Saturday-365/E-Shift-CZCD/THIRD_PARTY.md

# 第三方内容与许可证说明

仓库根目录的 GPL-3.0 适用于项目原创软件代码，不改变第三方组件原有的许可证和版权归属。

## STM32 HAL 与 CMSIS

各固件工程中的 `Drivers` 目录由 STM32CubeMX/STM32Cube 固件包生成或复制，包含 STMicroelectronics HAL 与 Arm CMSIS。

相关许可证文件随对应目录保留，例如：

- `Drivers/STM32F4xx_HAL_Driver/LICENSE.txt`
- `Drivers/CMSIS/LICENSE.txt`
- `Drivers/CMSIS/Device/ST/STM32F4xx/LICENSE.txt`

使用、修改和再分发这些文件时应遵守其各自许可证，而不是仅依据仓库根目录的 GPL-3.0。

## CyberGear 相关代码

`Sourse_Library/4_XMCyberGear_Libary` 包含 CyberGear 通信和控制实现。部分协议定义来源于电机公开资料及项目早期参考代码。

在来源和许可证逐文件核对完成前：

- 不应从根目录许可证推断所有第三方片段均可按 GPL 再授权。
- 新贡献需要注明参考资料、原作者和链接。
- 不应直接复制来源不明的完整驱动实现。

## ECU 与通信协议

ECU CAN 数据解析基于实际车辆接口、设备文档和调试结果。协议字段是否允许公开再分发应由使用者结合设备许可确认。

## 厂商软件、固件与手册

`4_Document` 中历史上保存过电机调试器、串口工具、设备固件和厂商手册。这些文件不一定具有公开再分发授权。

仓库整理原则：

- 优先保留项目原创说明和必要的公开标准。
- 厂商软件改为提供产品名称、版本和官方下载地址。
- 无法确认许可的 EXE、DLL、固件包和整套运行环境不继续纳入主分支。
- 引用厂商文档时保留标题、版本、来源链接和访问日期。

## 硬件、机械与文档

PCB、机械模型、图片和文档的独立许可证仍待团队确认。在车队成员和共同作者完成授权确认前，不应假定这些内容自动采用 GPL-3.0。

后续计划为原创软件、开放硬件和文档分别提供清晰的 SPDX 标识与许可证说明。
