Saturday-365/E-Shift-CZCD/docs/development-log.md

# 开发记录与设计说明

本文件保留项目中的故障、取舍和待验证方案。内容按证据成熟度区分为“已验证”“观察结果”和“方案阶段”。

## 已验证或已复现的问题

| 日期 | 记录 |
| --- | --- |
| 2025-03-30 | 基础版解决部分档位数据跳变，但出现从空档再次升档跳到二档的问题。 |
| 2025-06-20 | 调整升档断火触发时机，并增加断火等待。 |
| 2025-08-30 | 修改拨片按键处理，增加用户指示灯和空档设置按钮。 |
| 2025-09-04 | V3 PCB CAN 收发器出现接地不良，返修后继续测试。 |
| 2025-09-09 | V3 PCB 点火后出现 CAN 通信异常，临时切回 V2 PCB 保证出车。 |
| 2025-09-14 | 去除两处延时以提高换挡速度，后续测试因车辆机械故障中断。 |
| 2025-09-19 | PCB 更新至 V3.1。 |
| 2025-09-28 | 连续出车约 11 分钟后出现疑似电机过温保护。 |
| 2025-10-04 | 一档弹射测试后换挡电机支架弯曲，随后加急制作 10 mm 厚支架。 |
| 2025 比赛日 | 使用新支架完成比赛，湿地直线加速记录为 4.73 s 和 4.75 s。 |
| 2026-06-05 | 总结电控离合压降、换挡速度和降档转速匹配风险。 |

## 当前设计取舍

### 断火与补油

代码保留升档断火和降档补油接口，但比赛时未启用。主要原因包括：

- ECU 新固件无法按旧方式控制带档滑行时的电子节气门。
- 春风 CLX700 档位信号在切换中会短暂经过空档，影响按档位配置的断火时间。
- 赛季车辆测试时间不足，无法完成 ECU 与集成板的联合标定。

因此比赛阶段将油门配合交给车手。该取舍不能证明自动断火或补油逻辑已经完成验证。

### 电控离合

- 保持离合分离时观察到电池压降约 2 V，因此未用于起步。
- 不使用离合可以缩短换挡动作链路。
- 离合有助于提高换挡成功率，但恢复联动时机不当可能导致后轮转速突变。
- 若重新启用，应增加转速条件、动作超时和失效回退。

### 档位处理

当前档位稳定逻辑用于过滤换挡过程中短暂出现的空档。真实空档仍需要通过按键重新设置内部状态，这是待解决限制。

## 方案阶段：通过电机力矩识别入档

对于无法搭建独立档位传感器闭环的车辆，可研究使用 CyberGear 回传力矩或电流识别是否入档：

1. 记录换挡全过程中的位置、速度、力矩和电流。
2. 对齐已知成功、失败和卡滞换挡样本。
3. 分离机械限位、齿轮入档和异常阻力产生的力矩突变。
4. 使用阈值与持续时间构造初步检测器。
5. 在不同油温、转速、供电电压和机械磨损条件下验证。
6. 检测结果只能作为状态估计，必须保留超时和人工回退。

该方案目前没有进入主固件，也没有足够数据证明可靠性。

## 路线图

- 将阻塞式换挡流程改为周期推进的非阻塞状态机。
- 将车辆相关参数集中到独立配置文件。
- 为档位稳定、CAN 解析和状态机增加主机端测试。
- 增加 CAN 超时、电机过温和传感器异常保护。
- 按测试记录规范补充字段、单位、采样率和对应提交。
- 补充通用硬件生产文件及机械交换格式。
