Saturday-365/E-Shift-CZCD/images/README/1760525655132.png

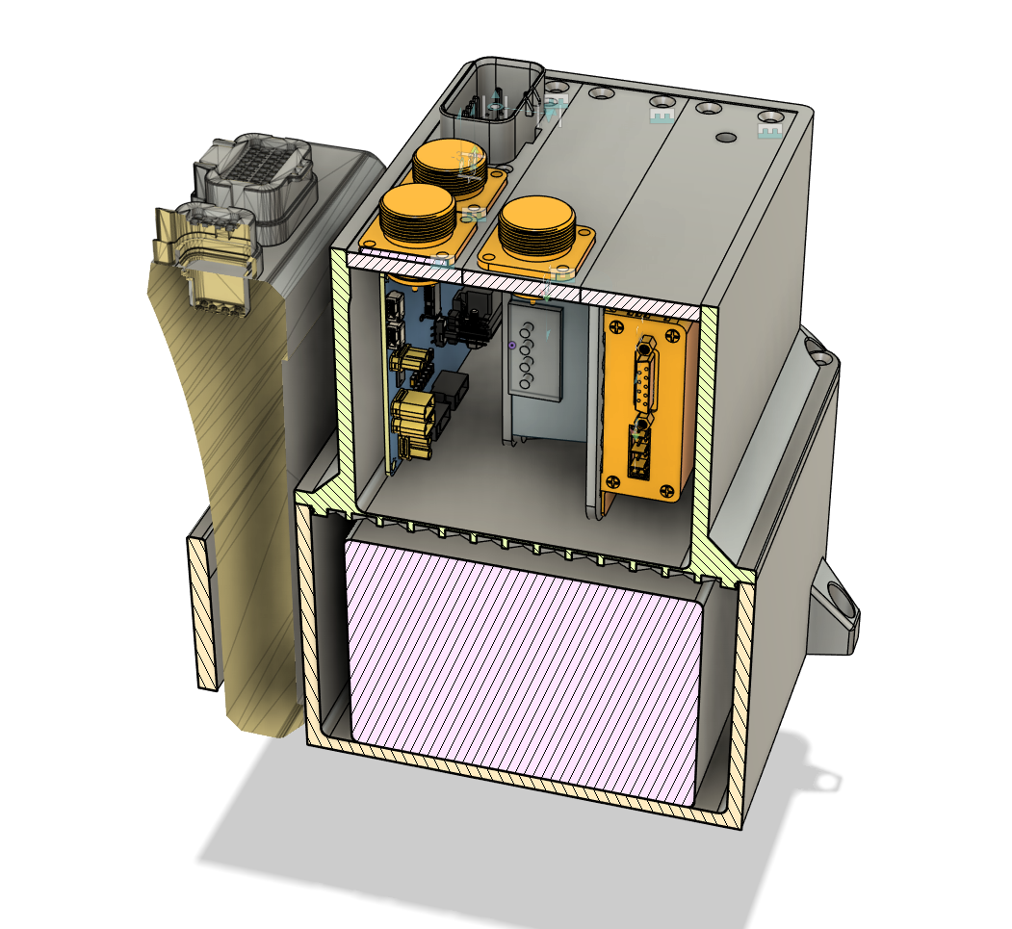
images/README/1760525655132.png
