Saturday-365/E-Shift-CZCD/images/README/1760610131903.png

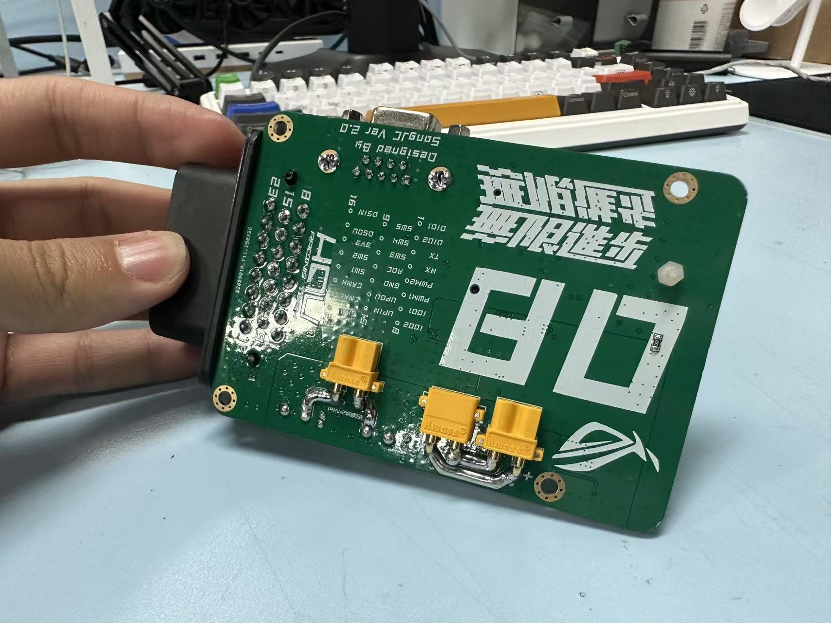
images/README/1760610131903.png
