Saturday-365/E-Shift-CZCD/images/README/1760610145923.png

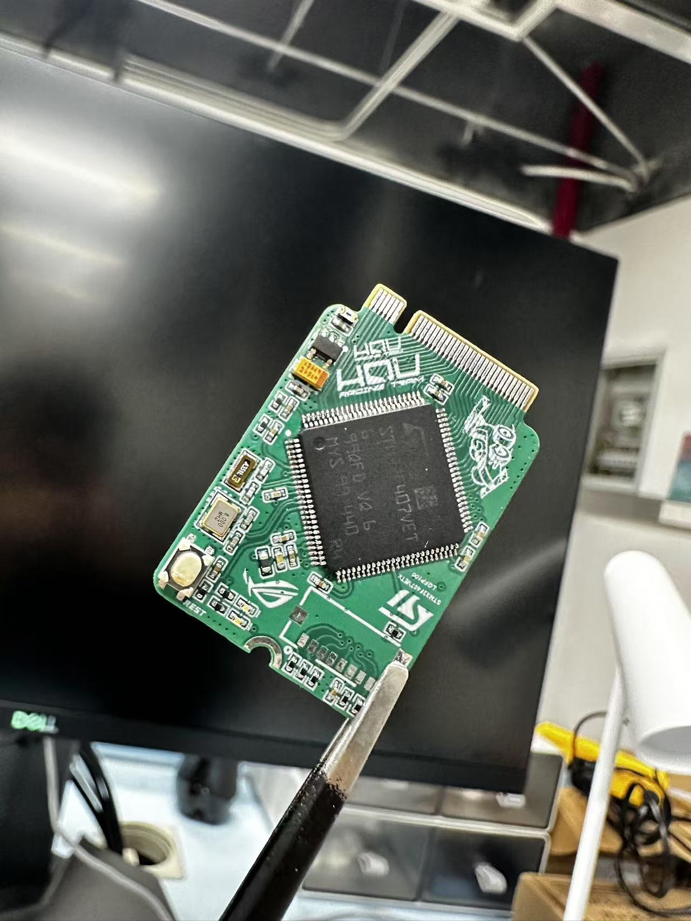
images/README/1760610145923.png
