Saturday-365/E-Shift-CZCD/images/README/1760610180186.png

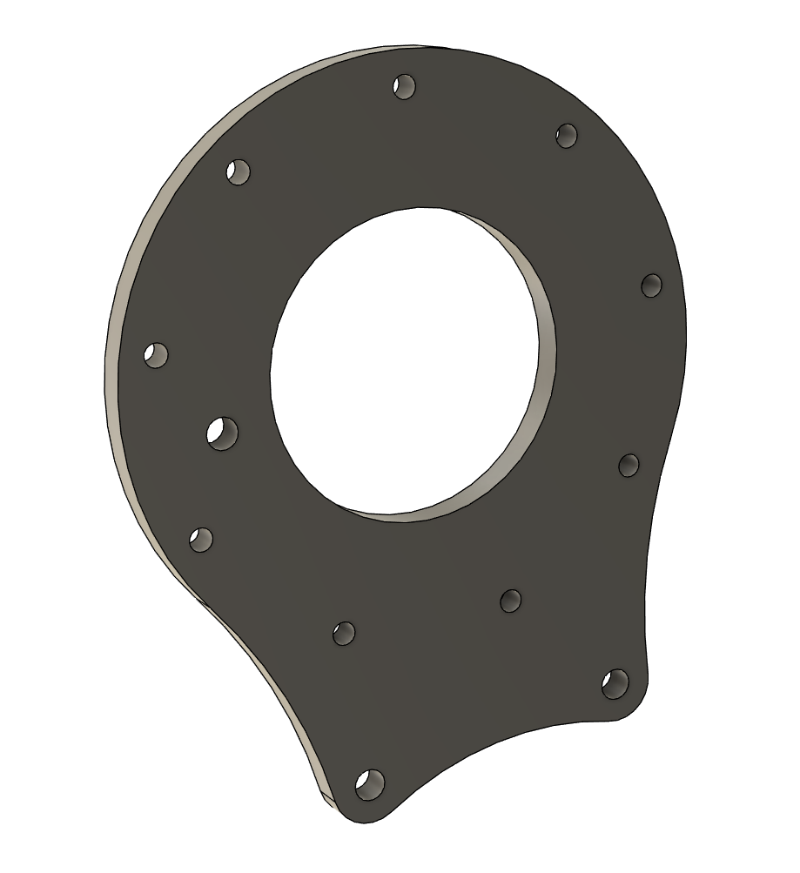
images/README/1760610180186.png
