Saturday-365/E-Shift-CZCD/images/README/1760610187072.png

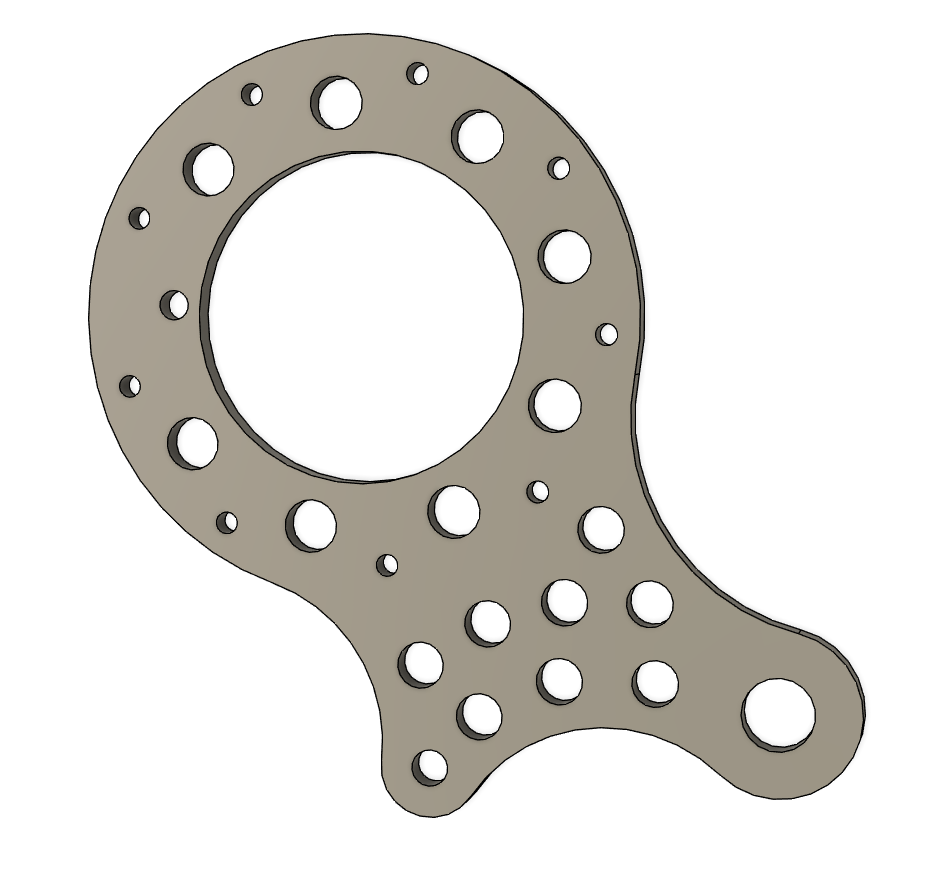
images/README/1760610187072.png
