Saturday-365/E-Shift-CZCD/images/README/1760610199821.png

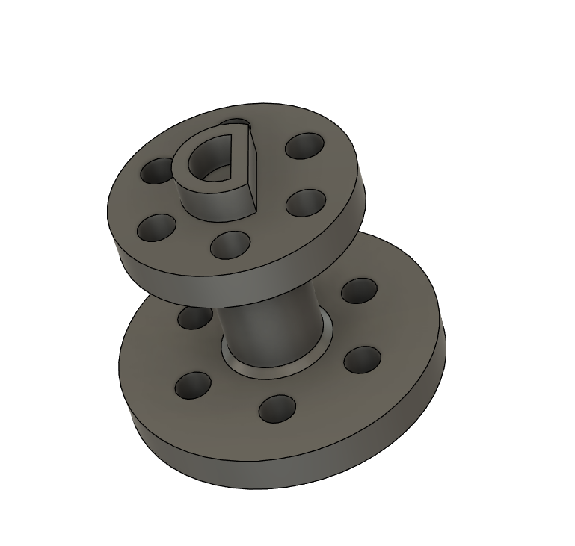
images/README/1760610199821.png
