Saturday-365/E-Shift-CZCD/images/README/1760611762846.png

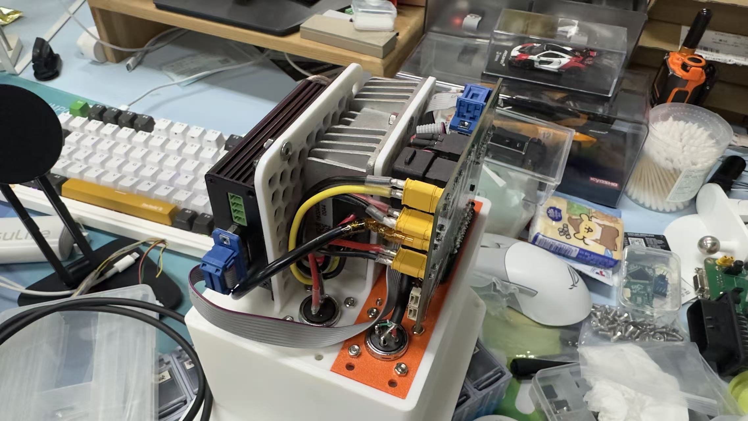
images/README/1760611762846.png
