Saturday-365/E-Shift-CZCD/images/README/1760611769713.png

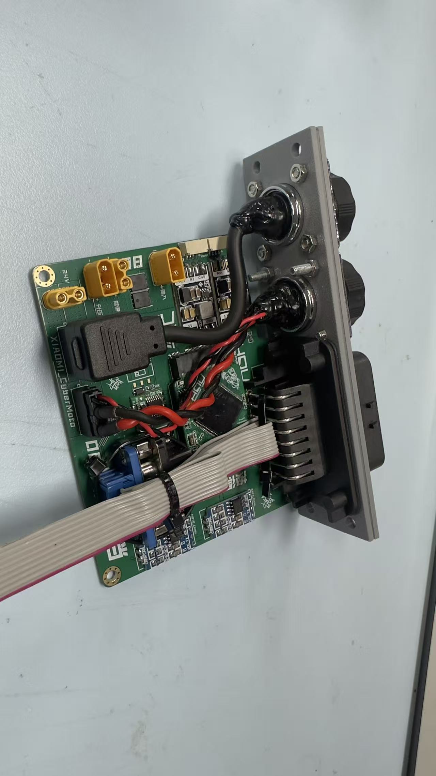
images/README/1760611769713.png
