Saturday-365/E-Shift-CZCD/(list of files, cad)

Other CAD files:
3_3DProject/换挡拉杆 v5.f3d
3_3DProject/电机支架面板1.1 v2.f3d
3_3DProject/电机支架面板2 v8.f3d
3_3DProject/离合拉线盘 v4.f3d
