Saturday-365/E-Shift-CZCD/CHANGELOG.md

# 变更记录

本项目采用语义化版本号。正式发布前的变更记录在 `Unreleased`。

## Unreleased

### Added

- 新增构建、架构、硬件、测试数据和开发记录文档。
- 新增贡献指南、安全策略和第三方许可证说明。
- 新增 GitHub Issue 表单、Pull Request 模板和 CODEOWNERS。
- 新增 `.gitignore` 与 `.gitattributes`。

### Changed

- 将 F407 DevBeta 收敛为唯一维护的 F407 主工程。
- 将 F103 和基础测试工程移动到 `legacy`。
- 重构 README，明确项目状态、构建入口和安全边界。
- 将测试数据文档调整为后续测试记录与发布规范。

### Removed

- 删除重复的 F407 BackUP 工程。
- 删除 Keil 编译产物、个人 IDE 状态和备份 ZIP。
- 删除无明确再分发许可的厂商软件、DLL、固件与完整资料包。
- 删除包含个人信息或与开源交付无关的课程报告。
- 删除缺少完整元数据的历史测试 CSV；旧记录仍可从整理前提交获取。

## 发布约定

每个 Release 至少应包含：

- 版本对应的提交哈希。
- 已验证的硬件与软件环境。
- 已知问题和安全限制。
- 如提供 HEX，附带文件校验值。
- 如提供 PCB 或机械生产文件，注明适用版本和制造参数。
