Saturday-365/E-Shift-CZCD/(list of files, drawings)

Other design files:
2_HardWare/ProPrj_102-HQU15集成板_Vel1.0.epro
2_HardWare/ProPrj_103-HQU15集成板-Vel3.1.epro
2_HardWare/ProPrj_103-HQU15集成板_Vel2.0.epro
2_HardWare/ProPrj_STM32F407核心板M.2_Vel1.0.epro
