Saturday-365/E-Shift-CZCD/1_SoftWare/Eshift_byCyberMotor_F407(DevBeta)/Core/Src/main.c

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
/* Includes ------------------------------------------------------------------*/
#include "main.h"
#include "adc.h"
#include "can.h"
#include "dma.h"
#include "i2c.h"
#include "tim.h"
#include "usart.h"
#include "gpio.h"

/* USER CODE BEGIN Includes */
#include "headfile.h"    //头文
#include "SA_E_shift.h"    //头文

/* USER CODE END Includes */

/* USER CODE BEGIN PTD */
#define overtime_tick_max 65534
/* USER CODE END PTD */


void SystemClock_Config(void);
/* USER CODE BEGIN 0 */
uint16_t overtime_tick;
uint8_t key_num;

/* USER CODE END 0 */

/**
  * @brief  The application entry point.
  * @retval int
  */
int main(void)
{

  /* MCU Configuration--------------------------------------------------------*/

  /* Reset of all peripherals, Initializes the Flash interface and the Systick. */
  HAL_Init();

  /* Configure the system clock */
  SystemClock_Config();

  /* USER CODE BEGIN SysInit */
    HAL_Delay(2000); //上电后延时2s，等待电平稳定后再初始化单片机
  /* USER CODE END SysInit */

  /* Initialize all configured peripherals */
  MX_GPIO_Init();
  HAL_GPIO_WritePin(USER_LED1_GPIO_Port,USER_LED1_Pin,GPIO_PIN_SET);  
  HAL_GPIO_WritePin(USER_LED2_GPIO_Port,USER_LED2_Pin,GPIO_PIN_SET);  
  MX_DMA_Init();
  MX_TIM1_Init();
  MX_ADC1_Init();
//  HAL_Delay(200); //上电后延时2s，等待电平稳定后再初始化单片机
  MX_CAN1_Init();
//  HAL_Delay(200); //上电后延时2s，等待电平稳定后再初始化单片机
USER_LED_BLINK(LED_GPIO_Port,LED_Pin,200);
  MX_CAN2_Init();
  USER_LED_BLINK(LED_GPIO_Port,LED_Pin,200);

//  HAL_Delay(200); //上电后延时2s，等待电平稳定后再初始化单片机
  MX_I2C1_Init();
  MX_I2C2_Init();
  MX_USART1_UART_Init();
  MX_USART2_UART_Init();
  MX_USART3_UART_Init();
  MX_TIM2_Init();
  MX_TIM3_Init();
  /* USER CODE BEGIN 2 */
    USER_LED_BLINK(USER_LED1_GPIO_Port,USER_LED1_Pin,200);    
   Init_DATA_CAN();
//    HAL_Delay(500); //上电后延时2s，等待电平稳定后再初始化单片机
    Motor_Init();
    USER_LED_BLINK(LED_GPIO_Port,LED_Pin,200);
    key_init(50);
    HAL_TIM_Base_Start_IT(&htim2);//定时器2 50ms中断开启
    HAL_TIM_Base_Start_IT(&htim3);//定时器3 50ms中断开启
//    HAL_GPIO_WritePin((GPIO_TypeDef *)LED_GPIO_Port, (uint16_t)LED_Pin, (GPIO_PinState)1);  //主循环工作指示灯
    USER_LED_BLINK(USER_LED2_GPIO_Port,USER_LED2_Pin,200);
  /* USER CODE END 2 */

  /* Infinite loop */
  /* USER CODE BEGIN WHILE */
  while (1)
  {
      HAL_GPIO_WritePin((GPIO_TypeDef *)LED_GPIO_Port, (uint16_t)LED_Pin, (GPIO_PinState)1);  //主循环工作指示灯

      Radio_Data_Send(&Clutch_Cyber,&Shift_Cyber,&ECUDATA,Real_Gear,1);//电台发送数据            
//      CANtest(&Clutch_Cyber,&Shift_Cyber);//基础串口调试代码
//      Set_Cyber_Pos(&Clutch_Cyber,0) ;  //设置电机归0
      Set_Cyber_Pos(&Shift_Cyber,0) ; //设置电机默认位置 （根据档位传感器的值决定默认位置 单位度数）
      
    if (key_get_state(UPSHIFTSIG)==KEY_PRESSED)
        {
            HAL_GPIO_WritePin(USER_LED1_GPIO_Port,USER_LED1_Pin,GPIO_PIN_RESET);  
            EShift_move(1,&ECUDATA);  //升档操作
            HAL_GPIO_WritePin(USER_LED1_GPIO_Port,USER_LED1_Pin,GPIO_PIN_SET);
            UPSHIFT_flag(0);            
        }
    else if (key_get_state(DOWNSHIFTSIG)==KEY_PRESSED)
        {
            HAL_GPIO_WritePin(USER_LED2_GPIO_Port,USER_LED2_Pin,GPIO_PIN_RESET);  
            EShift_move(0,&ECUDATA);  //降档操作
            HAL_GPIO_WritePin(USER_LED2_GPIO_Port,USER_LED2_Pin,GPIO_PIN_SET);
            DOWNSHIFT_flag(0);            
        }
    else if (key_get_state(SET_N)==KEY_PRESSED)
        {
            USER_LED_BLINK(USER_LED2_GPIO_Port,USER_LED2_Pin,200);
            set_gear_N();  //重置空档            
            USER_LED_BLINK(USER_LED1_GPIO_Port,USER_LED1_Pin,200);
        }


//    if (key_get_state(UPSHIFTSIG)==KEY_PRESSED)
//        {
//            Set_Cyber_Pos(&Shift_Cyber,40);  //设定离合位置
//            HAL_Delay(1000);

//        }
//    if (key_get_state(DOWNSHIFTSIG)==KEY_PRESSED)
//        {
//            Set_Cyber_Pos(&Shift_Cyber,10);  //设定离合位置
//            HAL_Delay(1000);

//        }


//if (key_get_state(DOWNSHIFTSIG)==KEY_PRESSED){

//   HAL_GPIO_WritePin(LED_GPIO_Port, (uint16_t)LED_Pin, (GPIO_PinState)0);  //主循环工作指示灯
//   HAL_Delay(1000);
//   HAL_GPIO_WritePin(LED_GPIO_Port, (uint16_t)LED_Pin, (GPIO_PinState)1);  //主循环工作指示灯
//}



//// 仪表指示灯测试
//   HAL_GPIO_WritePin(USER_LED1_GPIO_Port, (uint16_t)USER_LED1_Pin, (GPIO_PinState)0);  //主循环工作指示灯
//   HAL_GPIO_WritePin(USER_LED2_GPIO_Port, (uint16_t)USER_LED2_Pin, (GPIO_PinState)0);  //主循环工作指示灯
//   HAL_Delay(1000);
//   HAL_GPIO_WritePin(USER_LED1_GPIO_Port, (uint16_t)USER_LED1_Pin, (GPIO_PinState)1);  //主循环工作指示灯
//   HAL_GPIO_WritePin(USER_LED2_GPIO_Port, (uint16_t)USER_LED2_Pin, (GPIO_PinState)1);  //主循环工作指示灯
//   HAL_Delay(1000);

    /* USER CODE END WHILE */

    /* USER CODE BEGIN 3 */
  }
  /* USER CODE END 3 */
}

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
/* USER CODE BEGIN 4 */
void HAL_TIM_PeriodElapsedCallback(TIM_HandleTypeDef *htim){
    if(htim == &htim2)  //判断中断是否来自于定时器2
   {   
       overtime_tick++;
       if (overtime_tick > overtime_tick_max) overtime_tick=0;  //超时判断定时器中断
   }
   if(htim==&htim3)
   {
       key_scanner();
   }
}
            

void USER_LED_BLINK(GPIO_TypeDef *Port,uint16_t Pin,uint16_t time){
    HAL_GPIO_WritePin(Port,Pin,GPIO_PIN_RESET);  
    HAL_Delay(time);
    HAL_GPIO_WritePin(Port,Pin,GPIO_PIN_SET); 
    HAL_Delay(time);
    HAL_GPIO_WritePin(Port,Pin,GPIO_PIN_RESET);  
    HAL_Delay(time);
    HAL_GPIO_WritePin(Port,Pin,GPIO_PIN_SET);  
}

//单片机测试代码
//    HAL_GPIO_WritePin((GPIO_TypeDef *)LED1_GPIO_Port, (uint16_t)LED1_Pin, (GPIO_PinState)0); 
//    HAL_Delay(200);
//    HAL_GPIO_WritePin((GPIO_TypeDef *)LED1_GPIO_Port, (uint16_t)LED1_Pin, (GPIO_PinState)1);
//    HAL_Delay(200);
//    printf("samples: %d \n",a );
//    a++;
/* USER CODE END 4 */
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
