Saturday-365/E-Shift-CZCD/1_SoftWare/Eshift_byCyberMotor_F407(DevBeta)/Core/Inc/main.h

#define LED_Pin GPIO_PIN_13
#define LED_GPIO_Port GPIOC
#define SWITCH5_Pin GPIO_PIN_4
#define SWITCH5_GPIO_Port GPIOA
#define USER_LED1_Pin GPIO_PIN_6
#define USER_LED1_GPIO_Port GPIOA
#define USER_LED2_Pin GPIO_PIN_7
#define USER_LED2_GPIO_Port GPIOA
#define SWITCH3_Pin GPIO_PIN_4
#define SWITCH3_GPIO_Port GPIOC
#define SWITCH2_Pin GPIO_PIN_5
#define SWITCH2_GPIO_Port GPIOC
#define SWITCH1_Pin GPIO_PIN_0
#define SWITCH1_GPIO_Port GPIOB
#define DOWNSHIFTSIG_IN_Pin GPIO_PIN_1
#define DOWNSHIFTSIG_IN_GPIO_Port GPIOB
#define UPSHIFTSIG_IN_Pin GPIO_PIN_9
#define UPSHIFTSIG_IN_GPIO_Port GPIOE
#define DATA_CAN2_RX_Pin GPIO_PIN_12
#define DATA_CAN2_RX_GPIO_Port GPIOB
#define DATA_CAN2_TX_Pin GPIO_PIN_13
#define DATA_CAN2_TX_GPIO_Port GPIOB
#define IOOUT1_Pin GPIO_PIN_11
#define IOOUT1_GPIO_Port GPIOD
#define IOOUT2_Pin GPIO_PIN_12
#define IOOUT2_GPIO_Port GPIOD
#define DIO1_Pin GPIO_PIN_6
#define DIO1_GPIO_Port GPIOC
#define DIO2_Pin GPIO_PIN_7
#define DIO2_GPIO_Port GPIOC
#define MOTO_CAN1_RX_Pin GPIO_PIN_11
#define MOTO_CAN1_RX_GPIO_Port GPIOA
#define MOTO_CAN1_TX_Pin GPIO_PIN_12
#define MOTO_CAN1_TX_GPIO_Port GPIOA
#define UPSHIFTSIG_OUT_Pin GPIO_PIN_4
#define UPSHIFTSIG_OUT_GPIO_Port GPIOB
#define DOWNSHIFTSIG_OUT_Pin GPIO_PIN_5
#define DOWNSHIFTSIG_OUT_GPIO_Port GPIOB
