Saturday-365/E-Shift-CZCD/1_SoftWare/Eshift_byCyberMotor_F407(DevBeta)/Sourse_Library/1_SA_Library/SA_pid.h

#ifndef __SA_pid_H_
#define __SA_pid_H_
#include "common.h"
#include "SA_motor.h"

//    typedef struct
//    {
//    float SetSpeed;            //定义设定值
//    float ActualSpeed;        //定义实际值
//    float err;                //定义偏差值
//    float err_inte;            //定义偏差积分值
//    float err_last;            //定义上一次偏差值
//    float Kp;
//    float Ki;
//    float Kd;     //4.5 0.7 5.9     //定义比例、积分、微分系数
//    float incrementSpeed;


//    }SpeedPID_Typedef;

//    typedef struct
//    {
//    float SetAngle;            //定义设定值
//    float ActualAngle;        //定义实际值
//    float err;                //定义偏差值
//    float err_inte;            //定义偏差积分值
//    float err_last;            //定义上一次偏差值
//    float Kp;
//    float Kd;     //4.5 0.7 5.9     //定义比例、积分、微分系数
//    float incrementTorque;
//    }AnglePD_Typedef;
//    //void SpeedPID_Init(SpeedPID_Typedef *pid);   //速度环结构体参数定义
//    //void AnglePD_Init(AnglePD_Typedef *pd) ;  //速度环结构体参数定义
//    //float Angle_loop_PD(AnglePD_Typedef *pd, FOCmotor_Typedef *foc,float setAngle);

//    float KP_Fuzzy(float E,float EC);
//    float Kd_Fuzzy(float ECc);

#endif
