Saturday-365/E-Shift-CZCD/1_SoftWare/Eshift_byCyberMotor_F407(DevBeta)/Sourse_Library/1_SA_Library/headfile.h

#ifndef __HEADFILE_H_
#define __HEADFILE_H_

//#include "dma.h"

#include "main.h"
//HAL库头文件
#include "stdio.h"
#include "string.h"
//C语言头文件
#include "common.h"

#include "SA_eulerangles.h"
#include "SA_karman.h"
#include "SA_E_Shift.h"
#include "SA_pid.h"
#include "SA_Delay.h"
#include "SA_Usart.h"
#include "SA_Key.h"
#include "SA_Flash.h"

//#include "ATK_UART.h"
//#include "MT6701.h"



#include "SA_CANDataprocess.h"
#include "Cybergear_Control.h"
#endif
