Saturday-365/E-Shift-CZCD/1_SoftWare/Eshift_byCyberMotor_F407(DevBeta)/Sourse_Library/1_SA_Library/SA_uppercpu.h

#ifndef _JUSTFLOAT_H
#define _JUSTFLOAT_H

#define vofachanal 99    //  1 4 速度环   2 角度环；3 直立环  5 角度 距离测试  10 电感 滤波前 滤波后； 11电感无滤波 加error

//void vofatest();//串口调试函数
//void vofaprint();
//void Float_to_Byte(float f,unsigned char byte[]); //自写浮点转byte达到利用无线·串口输出波形
//float charTofloat(unsigned char *str);
//extern float vofa_test_1,vofa_test_2,vofa_test_3,vofa_test_4,vofa_test_5;
//void Vofa_PID_Adjust();

#endif
