Saturday-365/E-Shift-CZCD/(commit log)

2025-01-21 20250121 can hardware fail
    [ATK_UART.c, ATK_UART.h, CZCD_CanTrain.c, CZCD_CanTrain.h, MT6701.c, MT6701.h, SA_Delay.c]
2025-02-17 2025021701 motor can be control
    [0000259320_1_1_1_1_1.prt, 0000859389_1_1_1_1_1.prt, 0000859399_1_1_1_1_1.prt, 0411-2_4_1_3_1.prt, 0518_ASM_2_ASM_1_ASM_1_ASM_1_AS_ASM.prt, 0714_ASM_1_ASM_1_ASM_1_ASM.prt, 12345_ASM_1_ASM_2_ASM_1_ASM_1_A_ASM.prt, 1_1_02_EB671-500_1_1_1_1_1.prt]
2025-02-18 20250218 motor code unit
2025-03-07 Organize folders and update hardware files
    [0000259320_1_1_1_1_1.prt, 0000859389_1_1_1_1_1.prt, 0000859399_1_1_1_1_1.prt, 0411-2_4_1_3_1.prt, 0518_ASM_2_ASM_1_ASM_1_ASM_1_AS_ASM.prt, 0714_ASM_1_ASM_1_ASM_1_ASM.prt, 12345_ASM_1_ASM_2_ASM_1_ASM_1_A_ASM.prt, 1_1_02_EB671-500_1_1_1_1_1.prt]
2025-03-09 fix the time bug
    [SA_E_Shift.c]
2025-03-29 出车前代码修改 增加部分注释
2025-03-30 debug the jumpofgear 20250330 修复bug但是留下了降到空档后升档只能升2档的问题，等待下一次修改
    [SA_CANDataprocess.c, SA_E_Shift.c, STM32F407VET6_CUBMX.ioc, main.c]
2025-03-30 update20250330 README
    [20250330测试.csv]
2025-04-18 车车发动机坏了，git一下最近的更改，下一次就是在新车上面调试了，最近会晚上readme文件
    [202503.csv, 202504061131.csv, 202504061319.csv, 202504061402.csv, stm32计算器.xlsx, vofa+.csv]
2025-09-08 update V2.1
    [20250908晚出车前测试.csv]
2025-12-24 20251224 增加一份系统文档
2026-06-05 更新离合电机的说明
2026-07-30 在README中增加关于电机力矩感知的假设解决方案
2026-07-30 清理工程生成文件
2026-07-30 收敛主工程并重构文档
2026-07-30 清理第三方资料并补齐模板
    [0000259320_1_1_1_1_1.prt, 0000859389_1_1_1_1_1.prt, 0000859399_1_1_1_1_1.prt, 0411-2_4_1_3_1.prt, 0518_ASM_2_ASM_1_ASM_1_ASM_1_AS_ASM.prt, 0714_ASM_1_ASM_1_ASM_1_ASM.prt, 12345_ASM_1_ASM_2_ASM_1_ASM_1_A_ASM.prt, 1_1_02_EB671-500_1_1_1_1_1.prt]
2026-07-30 删除测试数据并补充说明
    [1.csv, 2.csv, 202503.csv, 20250306.csv, 202503221719.csv, 20250330测试.csv, 202504061131.csv, 202504061319.csv]
2026-07-30 完善复刻说明与安全边界
