Saturday-365/E-Shift-CZCD/(notices)

Notices in the files:
1_SoftWare/Eshift_byCyberMotor_F407/Core/Inc/main.h:
Copyright (c) 2025 STMicroelectronics.
All rights reserved.
This software is licensed under terms that can be found in the LICENSE file
README.md:
License: GPL-3.0
